intvenlab/camptraptions_timing/docs/diagrams/timing-sequences.md

# Timing sequence examples

Waveform-style views cross-linked to [scenarios.md](../scenarios.md). Use [parameters.md](../parameters.md) for configured values.

**Read this first:** [Nominal path (defaults)](#nominal-path-defaults) — HP OUT latched for the whole activity; exceptions are labeled below.

| Section | Scenario |
|---|---|
| **Nominal** | [SC-01](#nominal-path-defaults) — default happy path |
| A | [SC-04](../scenarios.md#sc-04--wake-timeout-no-fp) Wake timeout *(exception)* |
| B | [SC-06](../scenarios.md#sc-06--cold-fp-no-prior-wake) Cold FP *(exception)* |
| C | [SC-01](../scenarios.md#sc-01--normal-wake-then-shoot) Same as nominal (detail) |
| D | [SC-02](../scenarios.md#sc-02--fp-during-sequence-ignored) / [SC-03](../scenarios.md#sc-03--fp-flood-during-burst-ignored) FP ignored (R10) |
| E | [Burst scheduling](../behavior-spec.md#burst-frame-scheduling-within-one-sequence) StartFrameSpacingMin vs T |
| F | [SC-05](../scenarios.md#sc-05--back-to-back-sequence) Back-to-back sequence |
| G | [SC-07](../scenarios.md#sc-07--hp-during-active-burst) HP during burst *(exception input)* |
| H | [SC-16](../scenarios.md#sc-16--hp-input-released-immediately-after-fp) HP input release after FP |
| I | [SC-17](../scenarios.md#sc-17--first-frame-gated-by-short-hp-lead) Short HP lead |
| J | [SC-20](../scenarios.md#sc-20--t-greater-than-y-interaction) T greater than Y |
| K | Additional WaveDrom source coverage (SC-04b, 05b, 07b, 08-10, 12-15, 18-19) |

## Nominal path (defaults)

**This is the intended field behavior** with default parameters and `activityHalfPressHoldPolicy = holdUntilActivityEnd` (R7, R13).

| Parameter | Default | Role in this diagram |
|---|---|---|
| `minHalfPressBeforeShutter` (T) | 0.5 s | Gates frame 1 only if HP lead too short |
| `StartFrameSpacingMin` (Y) | 1.0 s | Min pulse-end-to-next-start between frames 2…N |
| `FrameCount` (N) | 4 | Shutter pulses per sequence |
| `PostShutterHalfPressHoldTimeExtension` (Z) | 2.0 s | HP hold after each FP pulse end; stock Z keeps HP continuous |
| `shutterPulseDuration` | 200 ms | FP OUT pulse width |
| `wakeHalfPressHoldTime` (X) | 10 s | Wake timeout anchored to initial HP assert; final HP release uses R15 max-rule |

**SC-01 timeline (stock):** HP wake t=0, FP accepted t=1.0 s (HP lead already ≥ T). With stock `Z=2.0 s` (`Z >= Y - T`), **camera HP OUT stays continuous** through burst. **No** extra T-wait between frames 2…N.

**Relax note:** If `Z` is small enough that `Z < (Y - T - 20 ms)`, HP may drop after each pulse’s Z hold and reassert `T` before the next frame. See [hp-relax-transition-spec.md](../hp-relax-transition-spec.md).

```mermaid
sequenceDiagram
    participant HPi as HP in
    participant FPi as FP in
    participant MCU
    participant HPo as HP out
    participant FPo as FP out

    HPi->>MCU: wake t=0
    MCU->>HPo: ON once latched
    Note over HPo: HP OUT high entire activity R7 R13
    FPi->>MCU: FP accepted t=1.0s starts sequence
    Note over MCU: R10 ignore all FP until burst done
    MCU->>FPo: frame 1 t=1.0s
    MCU->>FPo: frame 2 t=2.2s
    MCU->>FPo: frame 3 t=3.4s
    MCU->>FPo: frame 4 t=4.6s
    Note over MCU,HPo: PostShutterHalfPressHoldTimeExtension Z=2s HP still ON
    MCU->>HPo: OFF t≈10s activity end
```

**Camera outputs (SC-01 defaults)**

SC-01 nominal camera outputs

| Event | Time (s) |
|---|---|
| HP wake (HP OUT ON) | 0.0 |
| FP accepted (sequence start) | 1.0 |
| Frame 1 FP OUT start | 1.0 |
| Frame 2 FP OUT start | 2.2 |
| Frame 3 FP OUT start | 3.4 |
| Frame 4 FP OUT start | 4.6 |
| HP OUT OFF (after max-rule) | ~10.0 |

Exception paths: [A wake timeout](#a--sc-04-wake-only-then-timeout), [B cold FP](#b--sc-06-fp-without-prior-wake-cold-start), [G HP input during burst](#g--sc-07-hp-during-burst-no-effect-on-schedule), [H HP input release after FP](#h--sc-16-hp-input-release-after-fp), [I short HP lead](#i--sc-17-short-hp-lead), [J T greater than Y](#j--sc-20-t-greater-than-y), mid-burst HP OUT release in [behavior-spec](../behavior-spec.md#exception-path-hp-out-released-mid-burst).

---

## A — SC-04: Wake only, then timeout

*Exception — not the nominal shoot path.*

**Camera outputs (SC-04)**

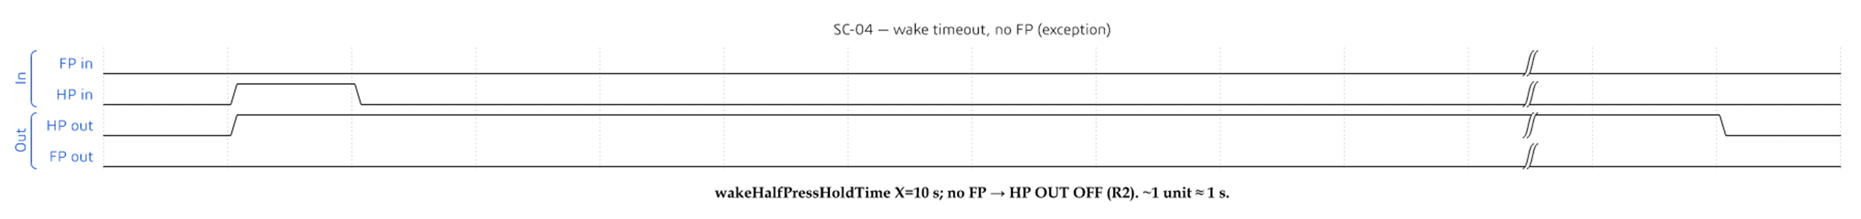
[picture p1: docs/diagrams/assets/sc04-wake-timeout.png]
SC-04 wake timeout


| Event | Time (s) |
|---|---|
| HP wake (HP OUT ON) | 0.0 |
| No FP | — |
| HP OUT OFF (`wakeHalfPressHoldTime` X=10) | ~10.0 |

```mermaid
sequenceDiagram
    participant HPi as HP input (wide PIR)
    participant MCU
    participant HPo as HP out (camera)
    participant FPi as FP input

    HPi->>MCU: glitchy pulses
    MCU->>HPo: ON (latched)
    Note over MCU,HPo: wakeHalfPressHoldTime = 10s
    Note over FPi: no FP
    MCU->>HPo: OFF
```

## B — SC-06: FP without prior wake (cold start)

*Exception — FP before any HP wake.*

**Camera outputs (SC-06)**

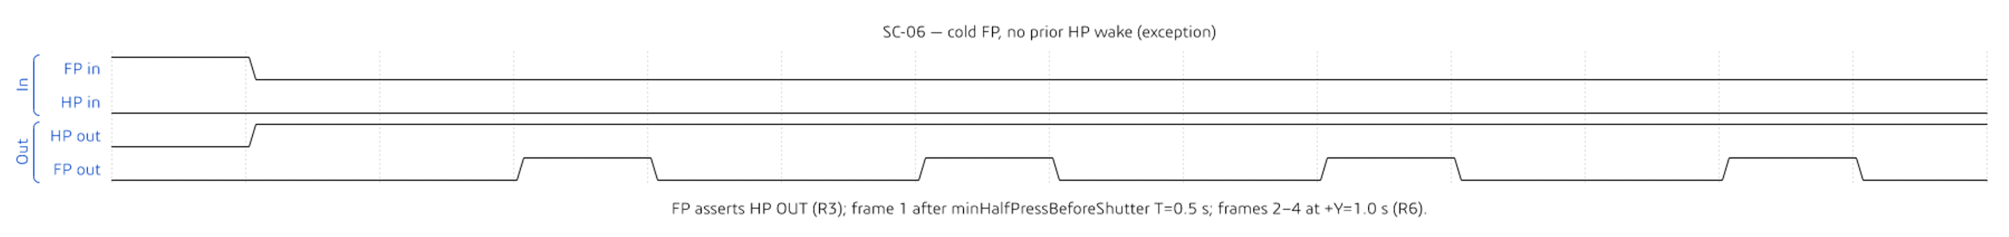
[picture p2: docs/diagrams/assets/sc06-cold-fp.png]
SC-06 cold FP


| Event | Time (s) |
|---|---|
| FP in (cold) | 0.0 |
| HP OUT ON (R3) | 0.0 |
| Frame 1 FP OUT start | 0.5 (after T) |
| Frame 2 FP OUT start | 1.6 |
| Frame 3 FP OUT start | 2.7 |
| Frame 4 FP OUT start | 3.8 |
| HP OUT OFF (after Z) | ~5.5 |

```mermaid
sequenceDiagram
    participant FPi as FP input
    participant MCU
    participant HPo as HP out
    participant FPo as FP out

    FPi->>MCU: FP assert
    MCU->>HPo: ON immediately
    Note over MCU: wait minHalfPressBeforeShutter T
    MCU->>FPo: frame 1
    Note over MCU: frames 2..N at StartFrameSpacingMin after prior pulse end HP stays on
```

## C — SC-01: Wake then FP at 1 s

Same as [Nominal path](#nominal-path-defaults). Canonical reference for acceptance tests.

## D — SC-02 / SC-03: FP ignored during sequence (R10)

*Overlay on nominal burst — PIR Gap minimum.*

MCU ignores **all** FP **inputs** from sequence start until the burst **schedule** completes (R10). `fullPressIgnoreGap` is a timing budget, not a per-retrigger window after each pulse.

**Camera outputs (SC-02)**

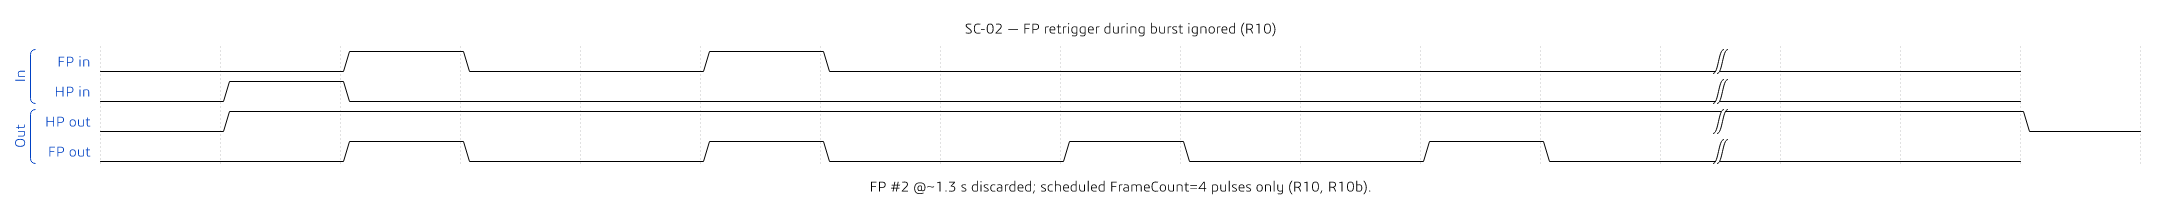
[picture p3: docs/diagrams/assets/sc02-fp-during-sequence.png]
SC-02 FP during sequence ignored


**Camera outputs (SC-03)**

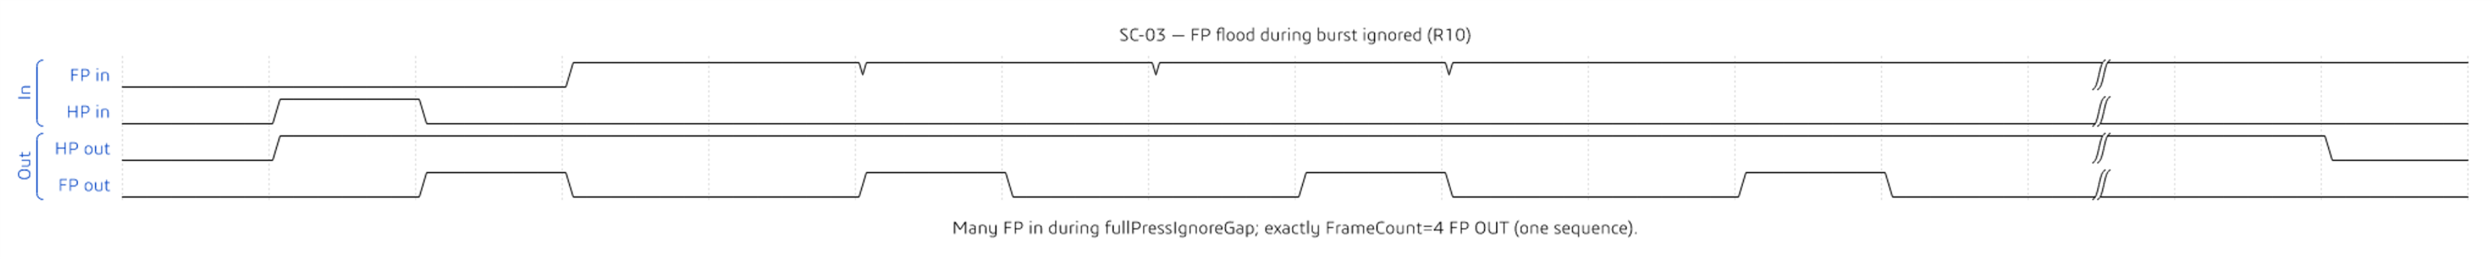
[picture p4: docs/diagrams/assets/sc03-fp-flood.png]
SC-03 FP flood ignored


```mermaid
sequenceDiagram
    participant FPi as FP_in
    participant MCU
    participant HPo as HP_out
    participant FPo as FP_out

    Note over HPo: HP OUT latched whole sequence
    FPi->>MCU: FP1 starts sequence
    Note over MCU: R10 discard FP until burst done
    FPi->>MCU: retriggers ignored
    MCU->>FPo: FrameCount scheduled pulses only
```

SC-03: many FP inputs during burst → still only `FrameCount` frames — see [scenarios.md](../scenarios.md#sc-03--fp-flood-during-burst-ignored).

## E — Burst schedule: StartFrameSpacingMin (min) vs minHalfPressBeforeShutter

*Nominal spacing when HP never drops — teaching example from behavior-spec (sequence start at HP assert).*

| Event | Time |
|---|---|
| HP asserted | 0.0 s |
| Frame 1 OUT | 0.5 s (after T) |
| Frame 2 OUT | 1.6 s |
| Frame 3 OUT | 2.7 s |
| Frame 4 OUT | 3.8 s |

Frames 2…N use **Y from prior pulse release** — no second T-wait. See [behavior-spec](../behavior-spec.md#burst-frame-scheduling-within-one-sequence).

**Camera outputs (SC-11)**

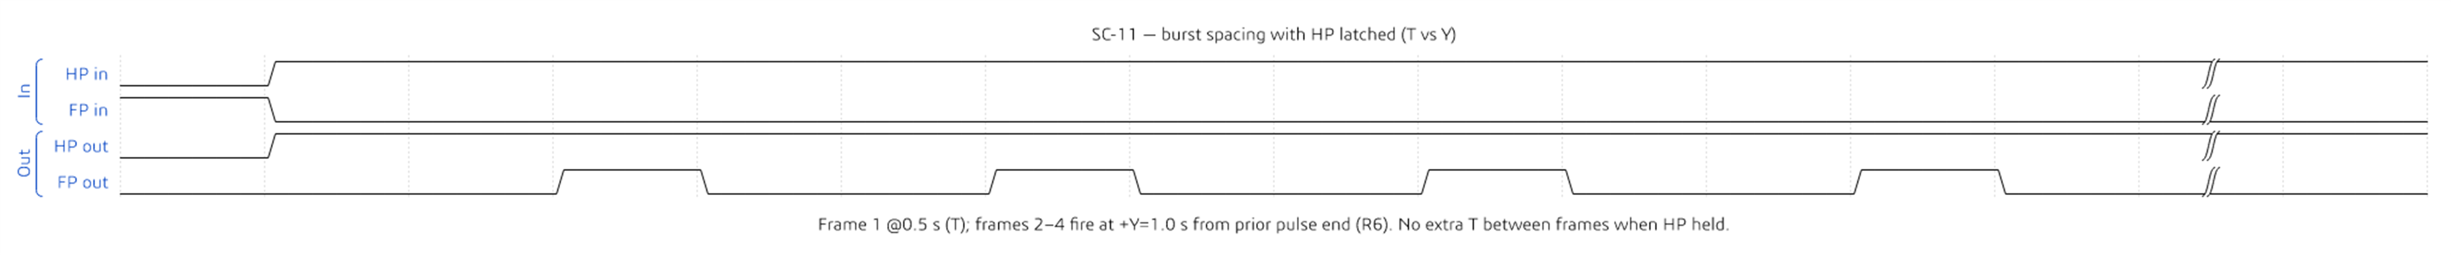
[picture p5: docs/diagrams/assets/sc11-burst-spacing.png]
SC-11 burst spacing


```mermaid
sequenceDiagram
    participant HPo as HP out
    participant FPo as FP out

    Note over HPo: ON latched entire burst R7
    Note over FPo: frame 1 at 0.5s after T
    Note over FPo: frame 2 at 1.6s +Y from prev release
    Note over FPo: frame 3 at 2.7s
    Note over FPo: frame 4 at 3.8s
```

## F — SC-05: Back-to-back sequence

*Nominal multi-sequence — HP OUT stays latched across both sequences (R13).*

**Camera outputs (SC-05)**

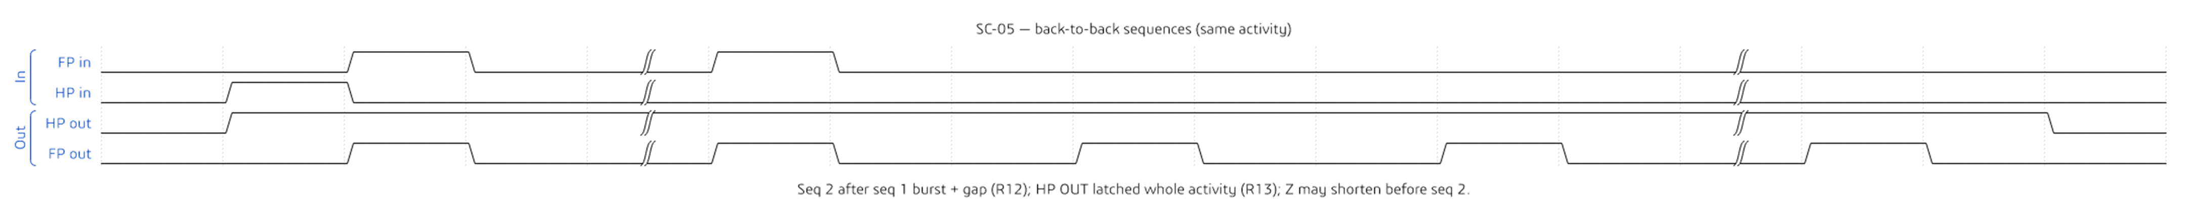
[picture p6: docs/diagrams/assets/sc05-back-to-back.png]
SC-05 back-to-back sequences


```mermaid
sequenceDiagram
    participant FPi as FP in
    participant MCU
    participant HPo as HP out
    participant FPo as FP out

    Note over HPo: HP ON entire activity no drop between sequences
    MCU->>FPo: sequence 1 frames
    Note over MCU,HPo: PostShutter extension may be shortened
    FPi->>MCU: FP2 accepted sequence 2 R12
    MCU->>FPo: sequence 2 frames
    Note over MCU,HPo: Z then release when activity ends
```

## G — SC-07: HP during burst (no effect on schedule)

*Exception input — wide PIR glitches during burst; schedule unchanged (R14).*

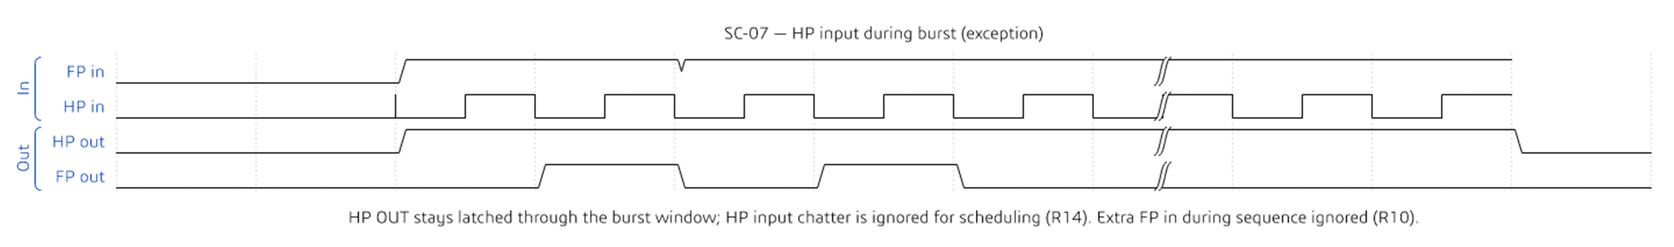
[picture p7: docs/diagrams/assets/sc07-hp-during-burst.png]
SC-07 HP during burst


HP **input** does not reset `remainingFrames` or add frames (**R14**). Camera HP **output** stays latched (**R7**). Extra FP **input** during the sequence is ignored (**R10**); only the scheduled `FrameCount` FP OUT pulses fire.

## H — SC-16: HP input release after FP

*Exception input — trigger HP input is short, but camera HP OUT remains latched by the MCU.*

SC-16 HP input release after FP

HP **input** may release before or immediately after FP input. In state-machine mode, that release is not mirrored to camera HP OUT. The MCU keeps HP OUT latched through the burst and `PostShutterHalfPressHoldTimeExtension`; if the HP lead is short, frame 1 waits for `minHalfPressBeforeShutter`.

```mermaid
sequenceDiagram
    participant HPi as HP in
    participant FPi as FP in
    participant MCU
    participant HPo as HP out
    participant FPo as FP out

    HPi->>MCU: short HP wake
    MCU->>HPo: ON latched
    HPi->>MCU: releases
    FPi->>MCU: FP accepted
    Note over MCU: frame 1 waits for T if HP lead short
    MCU->>FPo: FrameCount pulses
    Note over HPo: stays ON through burst and Z
```

## I — SC-17: Short HP lead

*Timing interaction — short HP lead delays frame 1, but does not alter later frame cadence while HP OUT is latched.*

SC-17 short HP lead

The first frame starts at:

```text
max(FP accept time, HP OUT assert time + minHalfPressBeforeShutter)
```

After frame 1, `StartFrameSpacingMin` controls the burst cadence as long as HP OUT remains latched. Even when `minHalfPressBeforeShutter > StartFrameSpacingMin` (SC-20), T must not be applied again before frames 2..N.

## J — SC-20: T greater than Y

*Dedicated view for the T>Y edge case. Frame 1 may be delayed by T, but T is not re-applied before frames 2..N.*

SC-20 T greater than Y

## K — Additional WaveDrom source coverage

The following scenarios now have maintained WaveDrom JSON sources under `docs/diagrams/wavedrom/` for validation and future embedding:

- `sc04b-repeated-wake.json`
- `sc05b-post-shutter-fp.json`
- `sc07b-post-burst-hp.json`
- `sc08-fp-before-hp.json`
- `sc09-sequence-cap.json`
- `sc10-recovery-after-cap.json`
- `sc12-hp-only.json`
- `sc13-debounce-bounce.json`
- `sc14-held-vs-pulsed-fp.json`
- `sc15-power-save-latency.json`
- `sc18-hp-chatter-burst.json`
- `sc19-new-event-after-release.json`
