intvenlab/camptraptions_timing/Swim Lane Diagrams.pdf

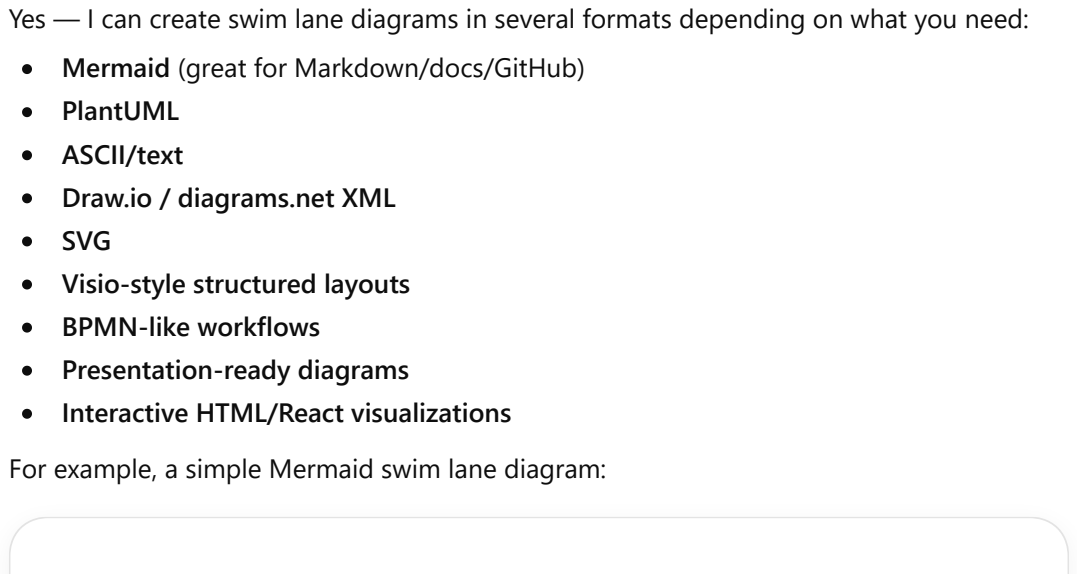
[picture p8: page 1]

Yes — I can create swim lane diagrams in several formats depending on what you need:
Mermaid (great for Markdown/docs/GitHub)
PlantUML
ASCII/text
Draw.io / diagrams.net XML
SVG
Visio-style structured layouts
BPMN-like workflows
Presentation-ready diagrams
Interactive HTML/React visualizations
For example, a simple Mermaid swim lane diagram:

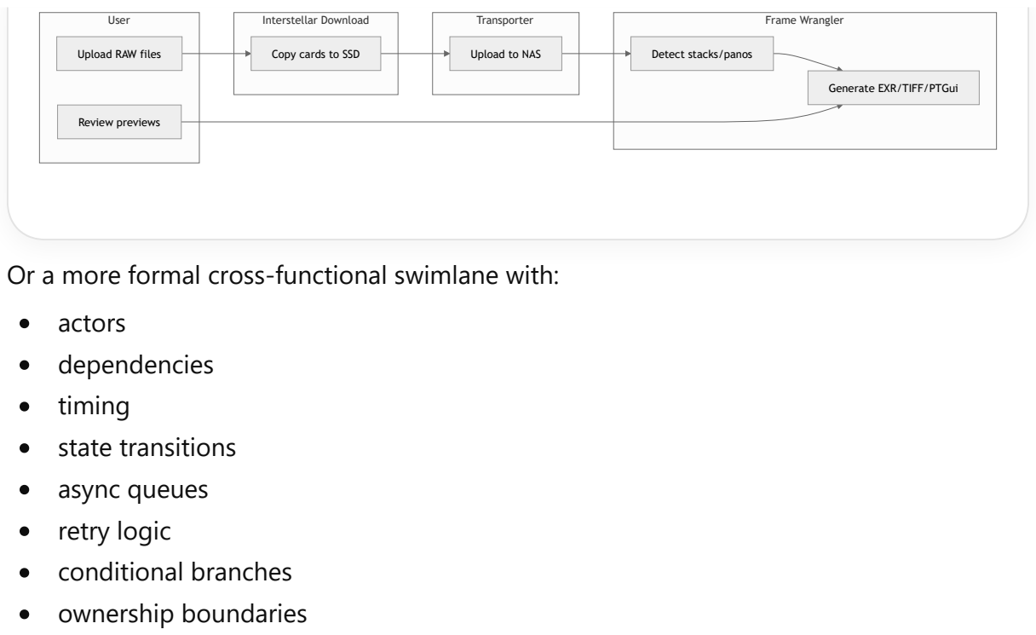
[picture p9: figure]
actors dependencies timing state transitions async queues retry logic conditional branches ownership boundaries; User; Interstellar Download; Transporter; Frame Wrangler; Upload RAW files; Review previews; Copy cards to SSD; Upload to NAS; Detect stacks/panos; Generate EXR/TIFF/PTGui

Or a more formal cross-functional swimlane with:

Given your existing workflows (like FrameWrangler, Interstellar Download, Transporter, and DAM automation), I can also generate:
engineering-grade workflow specs
pipeline orchestration diagrams
microservice interaction diagrams hardware/software responsibility lanes camera/ESP32 event timing diagrams If you want, give me:

### 1. The actors/lanes 2. The process steps 3. Any async events or decision points 4. Preferred format

…and I’ll generate the diagram directly.

Sources

Okay I'm going to have to give you this information in a few different chunks but this is not related to frame wrangler this is a different system. For this diagram we have a timing controlling microcontroller which sits

Okay I'm going to have to give you this information in a few different chunks but this is not related to frame wrangler this is a different system. For this diagram we have a timing controlling microcontroller which sits

Show more

between a motion activated trigger system from contraptions and the actual camera. The microcontroller has two sets of inputs and outputs One is half press the other is full press. The incoming trigger will send periodic but highly temporally unstable half press signals and will be configured to send a full press signal when a target
i l i i th | fi ld f i | W ill b

between a motion activated trigger system from contraptions and the actual camera. The microcontroller has two sets of inputs and outputs One is half press the other is full press. The incoming trigger will send periodic but highly temporally unstable half press signals and will be configured to send a full press signal when a target
i l i i th | fi ld f i | W ill b

Got it. I’ll collect the chunks first and avoid locking the diagram too early. So far I have four lanes/entities: motion trigger system, timing-control microcontroller, half-press path, full-press path, and camera.

Send the next chunk. I’ll keep building the model as you go.

Show more

Okay so here's where things get complicated and I'm not quite sure how to best illustrate this on the swim lane diagram. Effectively half press will not always show up before a full press signal. The half-press signals are really just a wake up from the motion sensor that's using a PIR wide-angle sensor. For that wake up signal or what we interpret as a half press input we need to send and latch the half-press output on the camera. This will force the camera to be auto focusing with the presumption that a full press signal will be coming soon. If we do not receive a full press within 30 seconds on assert the half press on the

Okay so here's where things get complicated and I'm not quite sure how to best illustrate this on the swim lane diagram. Effectively half press will not always show up before a full press signal. The half-press signals are really just a wake up from the motion sensor that's using a PIR wide-angle sensor. For that wake up signal or what we interpret as a half press input we need to send and latch the half-press output on the camera. This will force the camera to be auto focusing with the presumption that a full press signal will be coming soon. If we do not receive a full press within 30 seconds on assert the half press on the

Thought for a couple of seconds

Yes — this is best shown as two diagrams:

### 1. Swim lane / state flow for ownership and logic 2. Timing diagram for exact half/full press assertions

Draft swim lane in Mermaid:

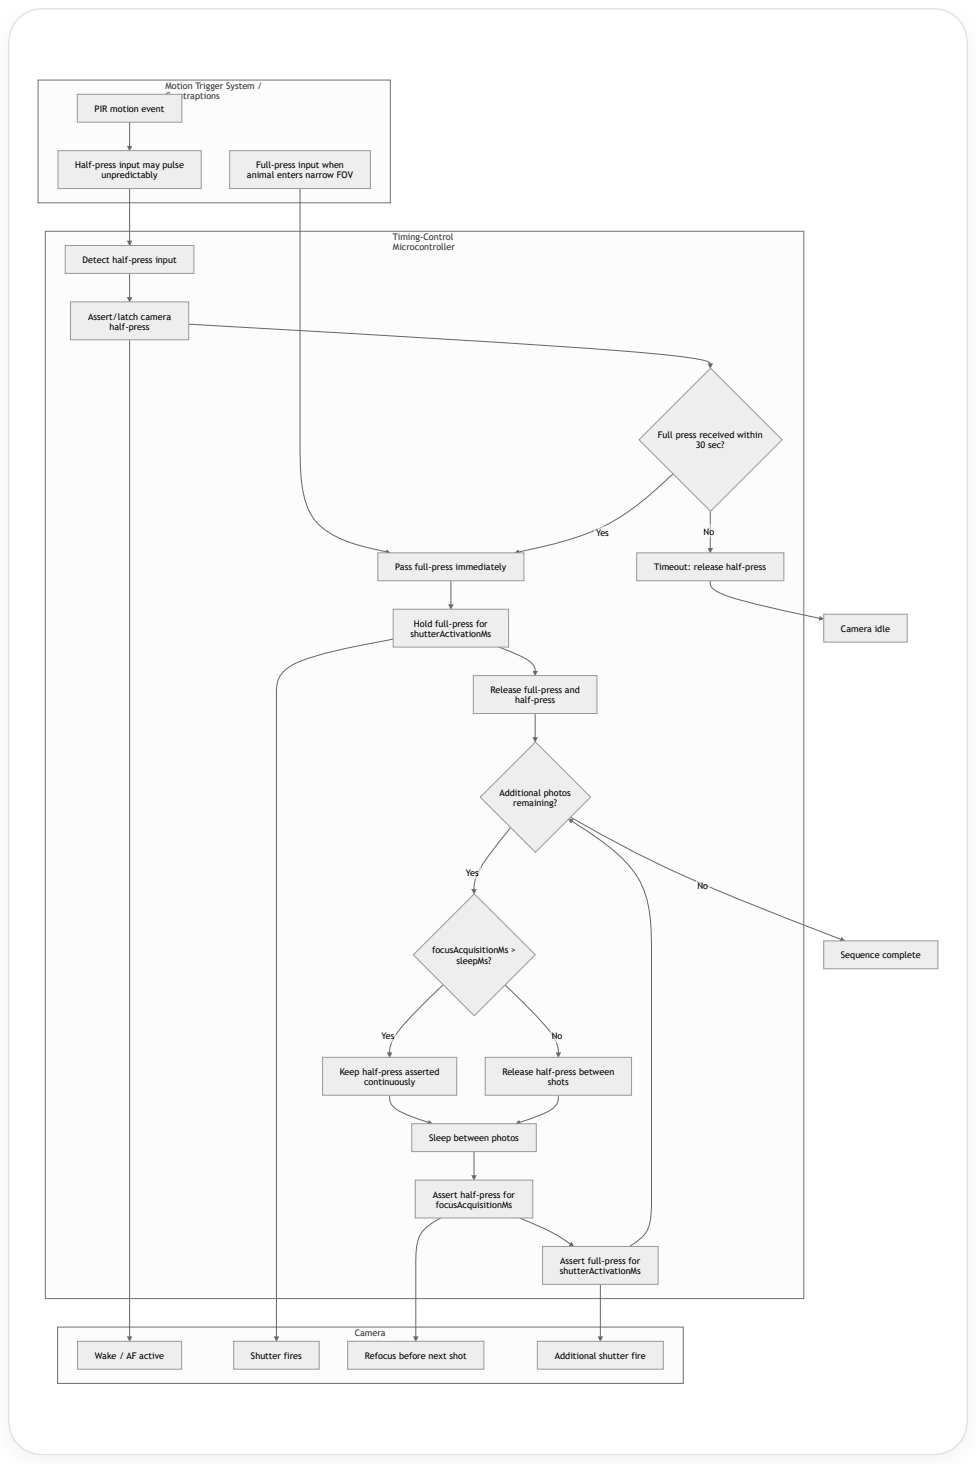
[picture p10: page 4]
Camera; Timing-Control Microcontroller; Yes; 30 sec?; Pass full-press immediately; Timeout: release half-press; Additional photos remaining?; focusAcquisitionMs > sleepMs?; shots; Wake / AF active; Shutter fires; Refocus before next shot; Additional shutter fire; Camera idle; Sequence complete

Motion Trigger System /
Camtraptions

PIR motion event

Half-press input may pulse
unpredictably

Full-press input when
animal enters narrow FOV

Detect half-press input

Assert/latch camera
half-press

Full press received within

Hold full-press for
shutterActivationMs

Release full-press and

Keep half-press asserted
continuously

Release half-press between

Sleep between photos

Assert half-press for
focusAcquisitionMs

Assert full-press for

And the behavior summary I’d encode in the diagram/spec:

For the final diagram, I’d probably label the MCU lane as a state machine, because that’s really what this is.

Parameters:
- halfPressTimeoutMs = 30000
- shutterActivationMs = configurable
- additionalPhotoCount = X
- sleepMs = configurable
- focusAcquisitionMs = configurable

Rules:
1. Half-press input is treated as wake/prepare, not as a stable camera command.
2. On half-press input, MCU latches camera half-press ON.
3. If no full-press input arrives within 30 seconds, MCU releases camera half-press.
4. Full-press input may arrive without a prior half-press.
5. On full-press input, MCU immediately asserts camera full-press.
6. MCU holds full-press for shutterActivationMs.
7. After the initial shot, MCU releases full-press and half-press, then starts the add
8. For each additional photo:
- wait sleepMs
- assert half-press for focusAcquisitionMs before shutter
- assert full-press for shutterActivationMs
9. If focusAcquisitionMs > sleepMs, half-press remains asserted continuously between s

Show more

ok - so -- let's put a pin in these diagrams for a moment --I'd like to work through a set of parameters we may want for control. Here's some requirements - but we know there are additional settings we need. Let's start making a list of parameters, their default values, and what behavior they define. We'll then circle back on the diagrams and update them.

1. Use an Arduino or other tiny, low power microcontroller. It would sit in between the camera trigger receiver and the camera – i.e. inline with the cable. So it receives the

ok - so -- let's put a pin in these diagrams for a moment --I'd like to work through a set of parameters we may want for control. Here's some requirements - but we know there are additional settings we need. Let's start making a list of parameters, their default values, and what behavior they define. We'll then circle back on the diagrams and update them.

1. Use an Arduino or other tiny, low power microcontroller. It would sit in between the camera trigger receiver and the camera – i.e. inline with the cable. So it receives the

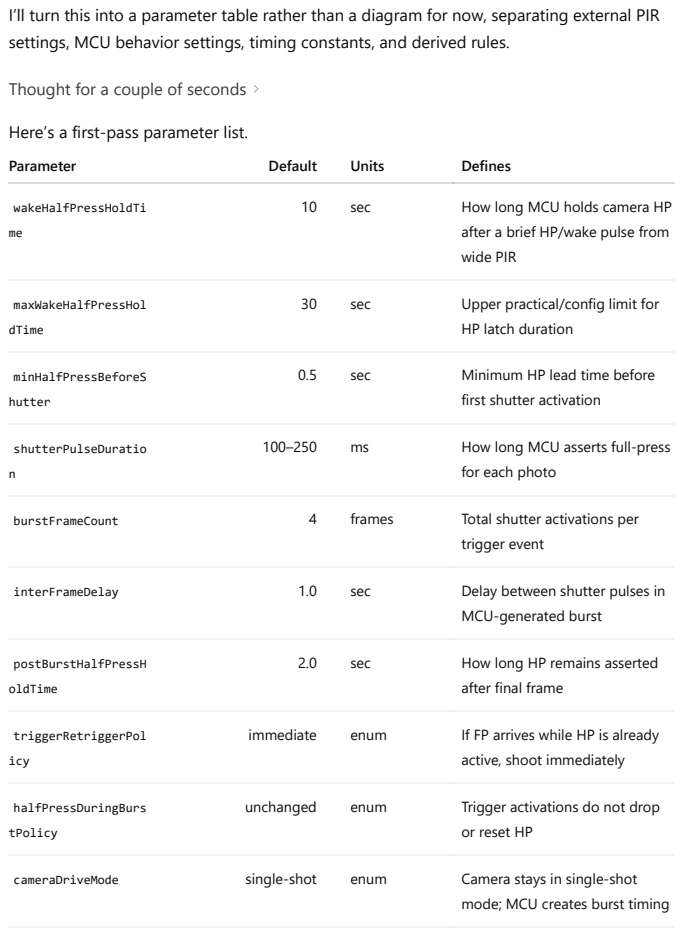
[picture p11: page 6]
Parameter; Default; Units; Defines; wakeHalfPressHoldTi; sec; How long MCU holds camera HP; maxWakeHalfPressHol; dTime; Upper practical/config limit for; minHalfPressBeforeS; hutter; Minimum HP lead time before; shutterPulseDuratio; How long MCU asserts full-press; burstFrameCount; frames; Total shutter activations per; trigger event; interFrameDelay; Delay between shutter pulses in; postBurstHalfPressH; oldTime; How long HP remains asserted; triggerRetriggerPol; icy; immediate; enum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

I’ll turn this into a parameter table rather than a diagram for now, separating external PIR
settings, MCU behavior settings, timing constants, and derived rules.

Thought for a couple of seconds

Here’s a first-pass parameter list.

after a brief HP/wake pulse from
wide PIR

HP latch duration

first shutter activation

for each photo

MCU-generated burst

after final frame

active, shoot immediately

or reset HP

mode; MCU creates burst timing

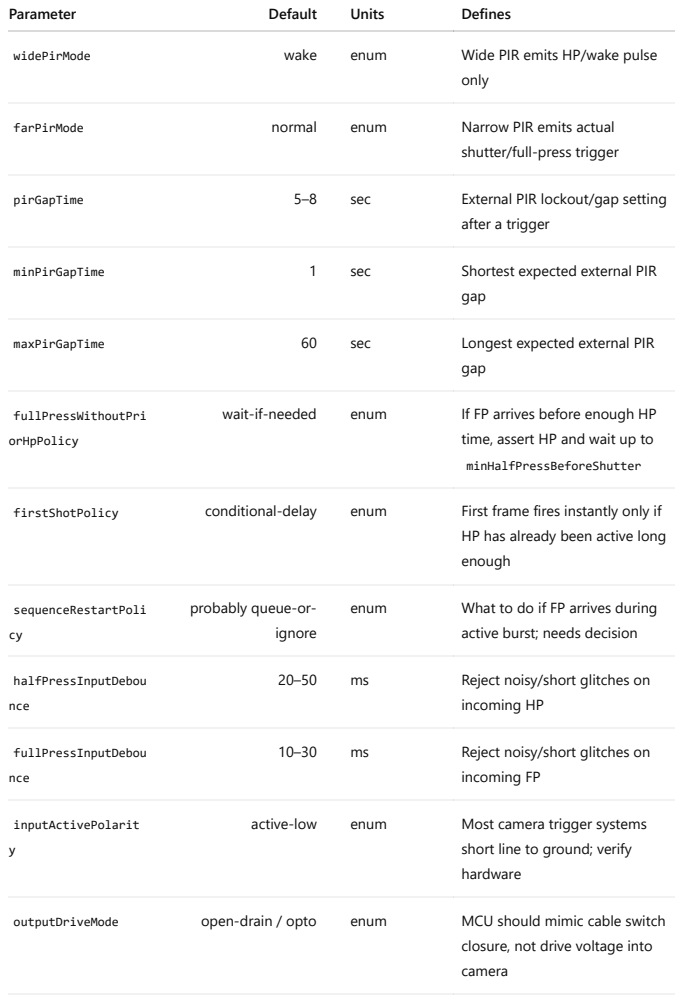
[picture p12: page 7]
Parameter; Default; Units; Defines; widePirMode; wake; enum; Wide PIR emits HP/wake pulse; only; farPirMode; normal; Narrow PIR emits actual; pirGapTime; sec; External PIR lockout/gap setting; after a trigger; minPirGapTime; Shortest expected external PIR; gap; maxPirGapTime; Longest expected external PIR; fullPressWithoutPri; orHpPolicy; wait-if-needed; If FP arrives before enough HP; minHalfPressBeforeShutter; firstShotPolicy; conditional-delay; First frame fires instantly only if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

shutter/full-press trigger

time, assert HP and wait up to

HP has already been active long
enough

probably queue-or-

active burst; needs decision

short line to ground; verify
hardware

closure, not drive voltage into
camera

Parameter | Default | Units | Defines
powerSaveIdleMode | enabled | bool | MCU sleeps when no HP/FP activity is active
statusLedMode | optional | enum | Disabled / debug / field-visible / field-dark

Core behavior in compact form:

Condition | | Behavior
HP wake pulse received | Assert camera HP and start/refresh

wakeHalfPressHoldTime

No FP before HP timer expires | Release camera HP

FP received and HP active for ≥

minHalfPressBeforeShutter

Fire first shutter immediately

FP received and HP not active long enough | Assert/keep HP, wait remaining time, then fire
Burst starts | Fire burstFrameCount shutter pulses
Between frames | Wait interFrameDelay
During burst | HP remains controlled independently; do not drop
HP because of FP pulses
After final frame | Keep HP asserted for
postBurstHalfPressHoldTime , then release unless
another timer/event requires HP

The one setting I’d decide next is sequenceRestartPolicy :

Option | Meaning
ignoreDuringBurst | FP inputs during a burst are ignored
extendAfterBurst | FP during burst schedules another burst after current one
restartBurstTimer | FP during burst restarts/extends the N-frame sequence

Option | Meaning
mergeIfHpActive | If HP still active, new FP immediately starts another N-frame sequence after current pulse spacing allows

My default recommendation: extendAfterBurst , because it avoids dropped detections without creating chaotic overlapping shutter timing.

Show more

hmm, we need to make some changes to this. For example, cameraDriveMode - no idea what this does, strike it or explain what we do with that. sequenceRestartPolicy - this isn't clearly defined. It's good to have this enum - but the core behavior we want isn't one of the described values. Our target mode is something like restartBurstTimer - but it's not a /timer/ -it's a shot count. Example: If we are on shot 4 of 6, and another full press comes in - we reset that counter to zero. We still need to honor all other timing parameters. However, we need to have an additional parameter which hmm, we need to make some changes to this. For example, cameraDriveMode - no idea what this does, strike it or explain what we do with that. sequenceRestartPolicy - this isn't clearly defined. It's good to have this enum - but the core behavior we want isn't one of the described values. Our target mode is something like restartBurstTimer - but it's not a /timer/ -it's a shot count. Example: If we are on shot 4 of 6, and another full press comes in - we reset that counter to zero. We still need to honor all other timing parameters. However, we need to have an additional parameter which

Agreed. Revised parameters:

Parameter | Default | Units | Defines

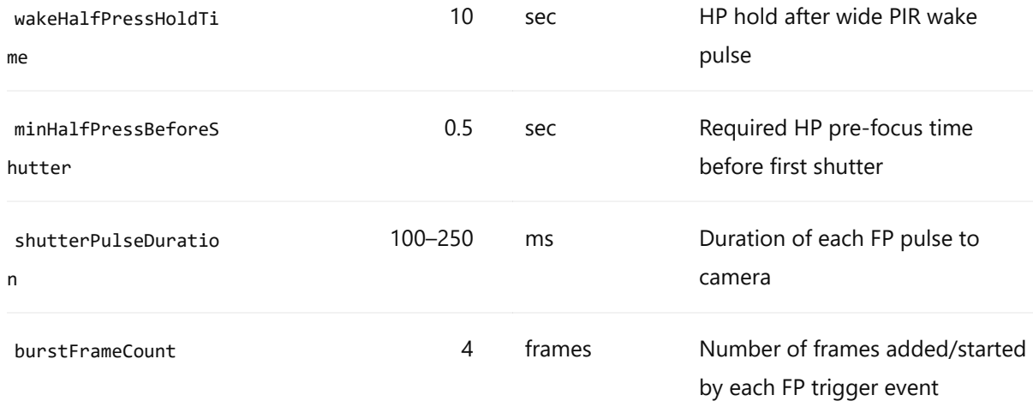
[picture p13: figure]
wakeHalfPressHoldTi; sec; HP hold after wide PIR wake; pulse; minHalfPressBeforeS; hutter; Required HP pre-focus time; before first shutter; shutterPulseDuratio; Duration of each FP pulse to; camera; burstFrameCount; frames; Number of frames added/started; by each FP trigger event
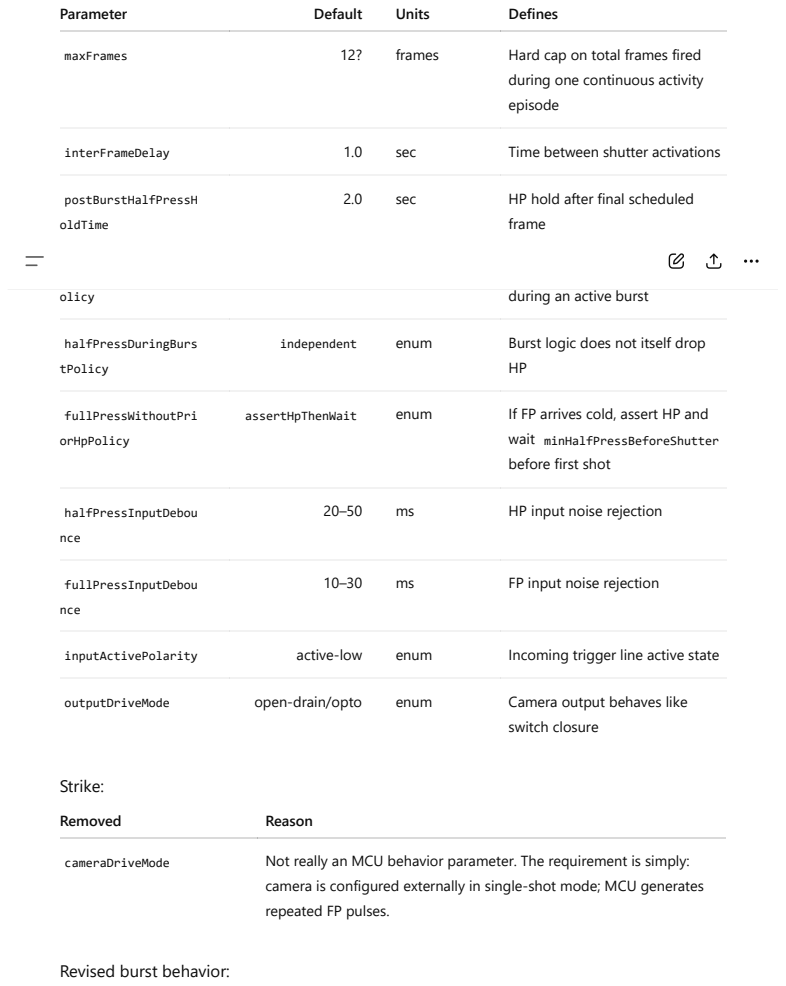
[picture p14: page 10]
Parameter; Default; Units; Defines; maxFrames; frames; Hard cap on total frames fired; interFrameDelay; sec; Time between shutter activations; postBurstHalfPressH; oldTime; HP hold after final scheduled; frame; triggerDuringBurstP; olicy; resetShotCount; enum; What happens when FP arrives; halfPressDuringBurs; tPolicy; independent; Burst logic does not itself drop; fullPressWithoutPri; orHpPolicy; assertHpThenWait; If FP arrives cold, assert HP and; halfPressInputDebou; nce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

during one continuous activity
episode

during an active burst

wait minHalfPressBeforeShutter
before first shot

camera is configured externally in single-shot mode; MCU generates
repeated FP pulses.

Revised burst behavior:

Condition | Behavior
FP received while idle | Start a new burst: remainingFrames = burstFrameCount , bounded by maxFrames
FP received on shot 4 of 6 | Reset burst progress: remainingFrames = burstFrameCount again
FP received repeatedly | Keep resetting scheduled burst count, but do not exceed maxFrames total frames for the current activity episode
maxFrames reached | Ignore/suppress further FP-triggered burst extension until current activity episode ends
Burst completes | Hold HP for postBurstHalfPressHoldTime , then release HP unless a fresh wake/trigger requires it

I’d name the enum:

Definition:

Example:

triggerDuringBurstPolicy = resetRemainingBurstFrames

When a new full-press input arrives during an active burst sequence, the MCU resets the remaining burst frame counter to burstFrameCount, subject to maxFrames for the current activity episode. Already-fired frames are counted toward maxFrames.
Timing constraints are still honored:
- no overlapping shutter pulses
- interFrameDelay still applies
- minHalfPressBeforeShutter still applies when HP has not been active long enough

burstFrameCount = 6
maxFrames = 12

Initial FP:
frame 1
frame 2
frame 3
frame 4

New FP arrives:

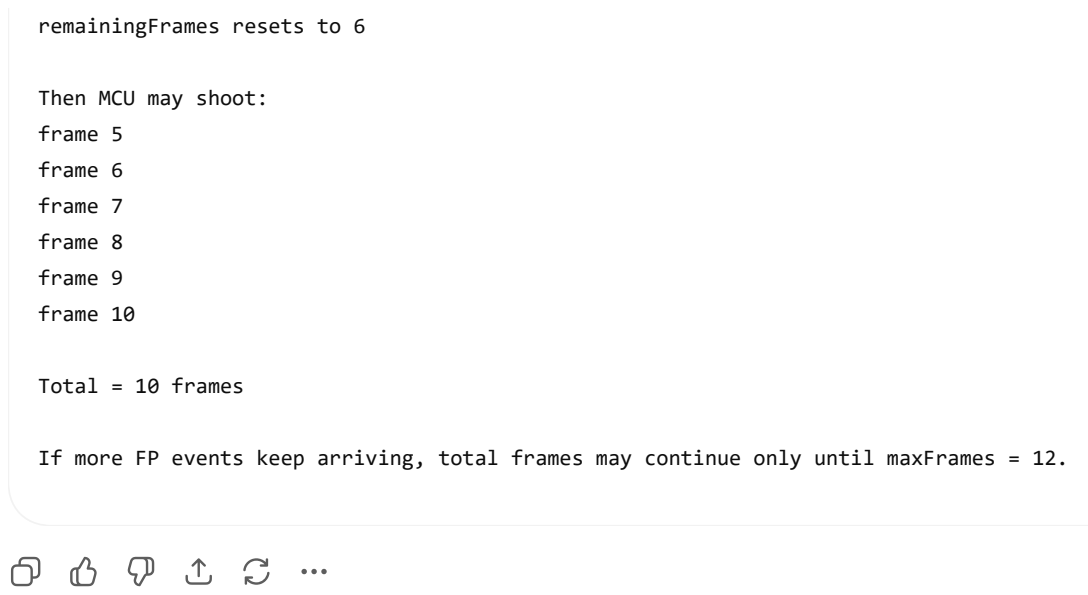
[picture p15: page 12]
Then MCU may shoot: frame 5 frame 6 frame 7 frame 8 frame 9 frame 10; Total = 10 frames

remainingFrames resets to 6

If more FP events keep arriving, total frames may continue only until maxFrames = 12.
