intvenlab/camptraptions_timing/TickleBoard/vectors/scenarios/AO-GAP-BOUNDARY-TRIAD.yaml

id: AO-GAP-BOUNDARY-TRIAD
scenario: ADDON-GAP-BOUNDARY
description: Hermetic fullPressIgnoreGap boundary triad with explicit runtime parameters
tags: [addon, boundary, hermetic]
parameters:
  enabled: 1
  wakeHalfPressHoldTime: 10s
  minHalfPressBeforeShutter: 0.5s
  shutterPulseDuration: 100ms
  StartFrameSpacingMin: 1.0s
  PostShutterHalfPressHoldTimeExtension: 2.0s
  halfPressInputDebounce: 35ms
  fullPressInputDebounce: 20ms
  FrameCount: 2
  MaxSequenceCount: 4
  wakeHoldRefreshPolicy: 0
  halfPressDuringBurstPolicy: 0
  fullPressWithoutPriorHpPolicy: 0
  activityHalfPressHoldPolicy: 0
  fpAfterMaxSequenceCountPolicy: 0
  inputActivePolarity: 0
  outputDriveMode: 0
  powerSaveIdleMode: 1
  fullPressIgnoreGap: 3.1s
fixture: { captureAfterLastStimulusMs: 15000 }
stimulus:
  - { atMs: 0, signal: HP_IN_STIM, state: active, durationMs: 100 }
  - { atMs: 1000, signal: FP_IN_STIM, state: active, durationMs: 100 }
  - { atMs: 4000, signal: FP_IN_STIM, state: active, durationMs: 80 }
  - { atMs: 4100, signal: FP_IN_STIM, state: active, durationMs: 80 }
  - { atMs: 4200, signal: FP_IN_STIM, state: active, durationMs: 80 }
expect:
  fpOut: { pulseCount: 4, frameSpacingMs: 1000 }
  timing:
    firstFrameGateDelayMs: { minMs: 0, maxMs: 50 }
  telemetryDeltas:
    acceptedFpCount: 2
    ignoredFpDuringGapCount: 2
    ignoredFpDuringBurstCount: 1
    MaxSequenceExceededCount: 0
    sequenceCompletedCount: 2
metrics: [ignoredFpCount]
