intvenlab/camptraptions_timing/TickleBoard/vectors/scenarios/AO-HPFP-SIMULTANEOUS-WAKE100-FC6.yaml

id: AO-HPFP-SIMULTANEOUS-WAKE100-FC6
scenario: ADDON-HPFP-SIMULTANEOUS
description: RETIRED diagnostic — use AO-HPRELAX-SIMULTANEOUS-INTENT. Kept as alias with hard pass expectations.
tags: [addon, retired-alias]
parameters:
  enabled: 1
  wakeHalfPressHoldTime: 10s
  minHalfPressBeforeShutter: 0.5s
  FrameCount: 6
  MaxSequenceCount: 4
  StartFrameSpacingMin: 1.0s
  PostShutterHalfPressHoldTimeExtension: 2.0s
  shutterPulseDuration: 100ms
  halfPressInputDebounce: 35ms
  fullPressInputDebounce: 20ms
  fullPressIgnoreGap: 5.0s
fixture:
  idleBeforeMs: 1200
  captureAfterLastStimulusMs: 12000
stimulus:
  - { atMs: 0, signal: HP_IN_STIM, state: active, durationMs: 100 }
  - { atMs: 0, signal: FP_IN_STIM, state: active, durationMs: 100 }
expect:
  fpOut: { pulseCount: 6, pulseWidthMs: 100, frameSpacingMs: 1000 }
  sequences: 1
  holdExpect:
    forbidInterFrameHpRelease: true
  timing:
    firstFrameGateDelayMs: { minMs: 450, maxMs: 650 }
  telemetryDeltas:
    acceptedFpCount: 1
    sequenceCompletedCount: 1
metrics: [firstFrameGateDelayMs, frameCount, sequenceCount, hpInterFrameReleaseCount]
