intvenlab/camptraptions_timing/TickleBoard/scripts/tickleboard/artifacts.py

from __future__ import annotations

from dataclasses import asdict, is_dataclass
from datetime import datetime
import json
from pathlib import Path
from typing import Any


def _jsonable(obj: Any) -> Any:
    if is_dataclass(obj):
        return asdict(obj)
    if isinstance(obj, dict):
        return {str(k): _jsonable(v) for k, v in obj.items()}
    if isinstance(obj, list):
        return [_jsonable(v) for v in obj]
    return obj


def create_run_dir(root: Path, case_id: str) -> Path:
    stamp = datetime.now().strftime("%Y%m%d_%H%M%S")
    out = root / f"{stamp}_{case_id}"
    out.mkdir(parents=True, exist_ok=True)
    return out


def write_json(path: Path, payload: Any) -> None:
    path.write_text(json.dumps(_jsonable(payload), indent=2, sort_keys=True), encoding="utf-8")


def write_text(path: Path, text: str) -> None:
    path.write_text(text, encoding="utf-8")
