intvenlab/camptraptions_timing/TickleBoard/scripts/tickleboard/debug_log.py

from __future__ import annotations

from pathlib import Path
import json
import time
import uuid


_LOG_PATH = Path(__file__).resolve().parents[3] / "debug-34b2c6.log"
_SESSION_ID = "34b2c6"


def debug_log(run_id: str, hypothesis_id: str, location: str, message: str, data: dict[str, object]) -> None:
    payload = {
        "sessionId": _SESSION_ID,
        "id": f"log_{int(time.time() * 1000)}_{uuid.uuid4().hex[:8]}",
        "timestamp": int(time.time() * 1000),
        "runId": run_id,
        "hypothesisId": hypothesis_id,
        "location": location,
        "message": message,
        "data": data,
    }
    with _LOG_PATH.open("a", encoding="utf-8") as fp:
        fp.write(json.dumps(payload, separators=(",", ":")) + "\n")
