intvenlab/camptraptions_timing/(commit log)

2026-05-20 Add validation plan, HP edge-case scenarios, and telemetry design notes
    Expanded the timing MCU documentation with a repeatable fixture-driven validation plan covering SC-01 through SC-20, including BLE/GATT parameter setup, edge timestamp logging, latency checks, parameter sweeps, and telemetry capture. Added HP behavior scenarios for release/chatter during bursts, short HP lead timing, post-release cold behavior, and T > Y frame spacing. Also documented the telemetry approach as RAM-first with rate-limited LittleFS snapshots for coarse lifetime counters, keeping high-churn runtime state out of persisted camera configuration.
    [Camtraptions_Firmware.ino]
2026-05-21 Add TickleBoard validation harness, test report, and docs/export updates
    ## Summary
    This update adds a complete validation/testing workflow for the Camtraptions timing controller, including a new `TickleBoard` fixture harness, scenario vectors, automated test suites, and a consolidated validation report. It also updates core docs and diagrams to reflect current firmware behavior, telemetry/parsing contracts, and policy coercion rules, while improving doc export support for validation outputs.
    ## What Changed
    - Added `TickleBoard/` (fixture firmware, Python runner, vectors, suites, and run artifacts)
    - Added `docs/validation-test-report.md`
    - Expanded `docs/validation-test-plan.md` (tracea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
    [full_test_rollup.csv]
2026-05-21 more testing...
    [suite_rollup.csv]
2026-05-22 pasted all tests!
    ## Changes Overview
    ### Firmware
    - **`Camtraptions_Firmware/Camtraptions_Firmware.ino`**
    - Prioritized camera control timing over BLE housekeeping while connected.
    - Added adaptive BLE/telemetry service budgets for active/post/idle phases.
    - Switched connected idle behavior to event-driven wait (`__WFE`) instead of fixed delays.
    - Added telemetry event for exact ignore-gap boundary acceptance: `FP_ACCEPTED_AT_GAP_BOUNDARY`.
    - Adjusted HP handling to assert `HP_OUT` immediately when HP input arrives.
    ### Fixture Firmware
    - **`TickleBoard/TickleBoardBits/TickleBoardBits.ino`**
    - Refactored edge logging to enum-based signal IDs.
    - Stabilized fixture pin bring-u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
    [suite_rollup.csv]
2026-05-22 changed max sequence count behavior and added some sweep tests.
    [suite_rollup.csv]
2026-05-22 major restructuring of firmware
    broken into a few files.
    [suite_rollup.csv]
2026-05-23 fixed a testing bug
    SC16 was failing timing - turns out, changing settings adds a 50ms delay to everything, which was causing a problem. Added a 1 second sleep after each reconfiguration over ble fixed the test. In practice, we wont' do this.
    [Camtraptions_Firmware.ino, ble_adapter.py, camera.cpp, config.h, constants.py]
2026-05-24 final test report
    [suite_rollup.csv]
2026-05-26 changed factory reset parameters
    No longer changes device settings (battery, group, etc) but otherwise resets all timing parameters.
    [gatt.cpp]
2026-08-07 Redefine PostShutterHalfPressHoldTimeExtension (Z) as HP hold after every FP pulse, allow Z=0, and release/reassert HP between frames only when Z < (Y − T − 20 ms). Stock timing stays continuous. Fix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
    Behavior
    No new mode byte — continuous vs relaxed HP comes from existing T / Y / Z.
    Z is hold after each FP pulse end (not only post-sequence).
    Inter-frame drop only when there is enough slack for lead ≥ T after reassert; otherwise HP stays latched.
    Simultaneous HP+FP at idle is valid shoot intent (first frame still gated by T).
    Firmware
    storage.cpp: sanitize al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
    [report.csv]
